AdakHaddad/BALAT/BALAT_PCB_v1/BALAT_PCB_v1/CETAK_SETRIKA_A4.pdf

## BALAT - pola tembaga untuk transfer setrika (2 kalung)

Cetak printer LASER, skala 100% / ukuran sebenarnya (matikan 'fit to page'). JANGAN dicerminkan: pola ini sudah benar untuk lapisan bawah. Hitam = tembaga yang dipertahankan. Titik putih kecil = tanda pusat bor (0,8-1 mm).

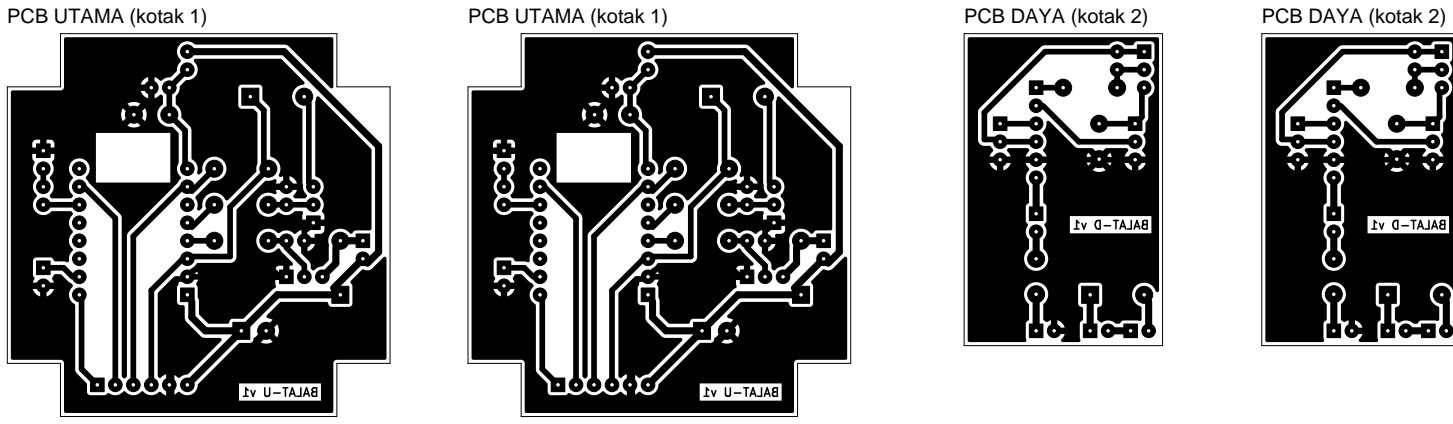
[picture p1: figure]
PCB UTAMA (kotak 1); PCB DAYA (kotak 2)
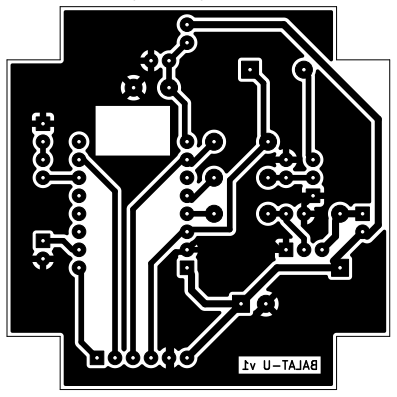
[picture p2: figure]

Garis ini harus tepat 50 mm. Ukur dengan penggaris sebelum menyetrika.

PCB utama = 54 x 54 mm, PCB daya = 28 x 44 mm. v1 | BALAT-U | v1 | BALAT-U
