AdakHaddad/BALAT/BALAT_PCB_v1/BALAT_PCB_v1/peta_daya.png

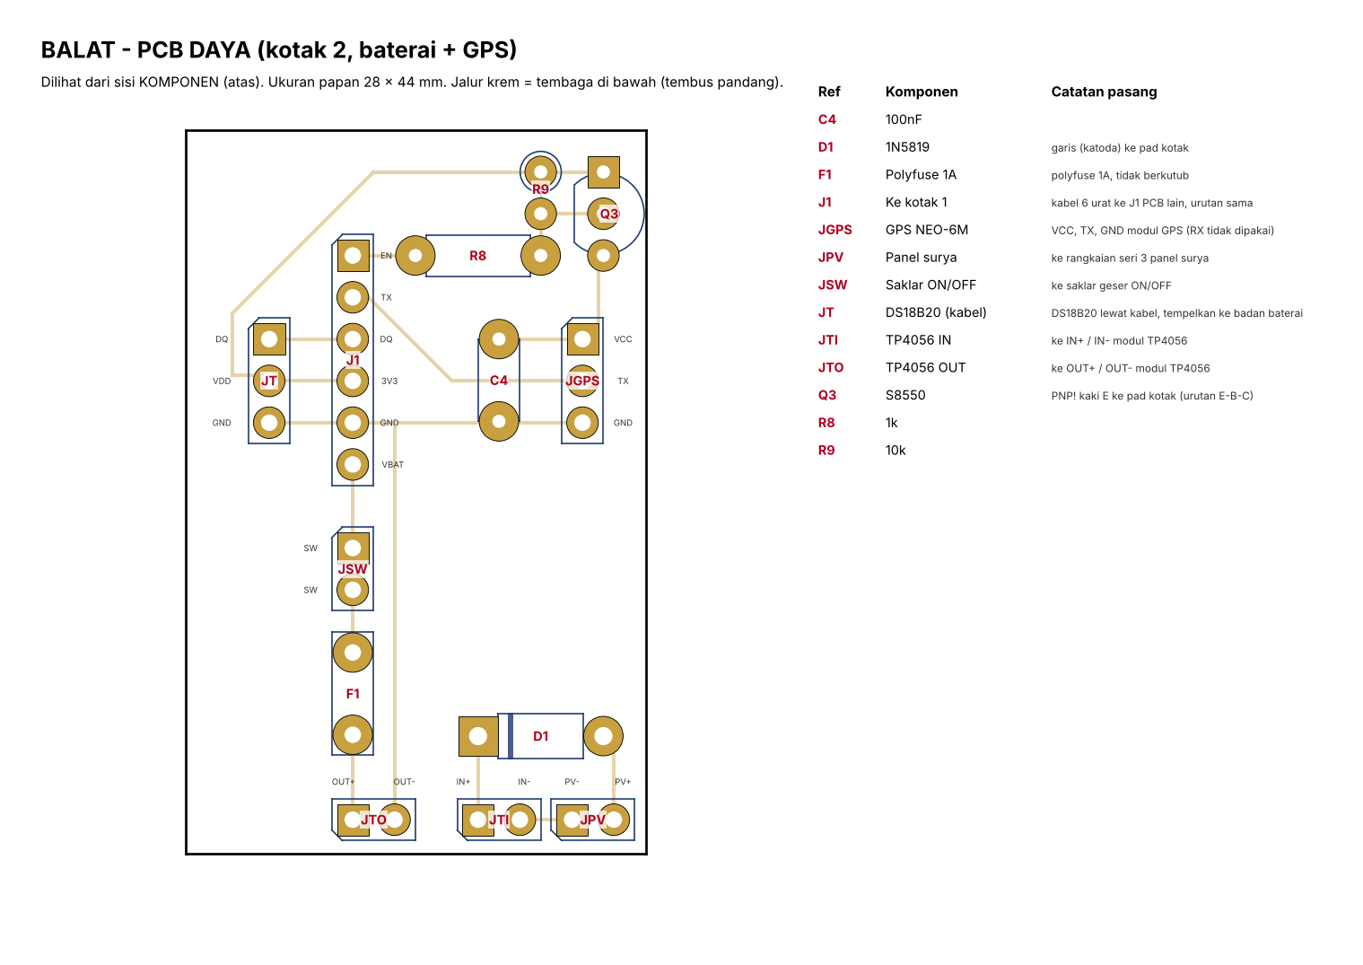
BALAT_PCB_v1/BALAT_PCB_v1/peta_daya.png
