AdakHaddad/BALAT/BALAT_PCB_v1/BALAT_PCB_v1/pratinjau_pcb.png

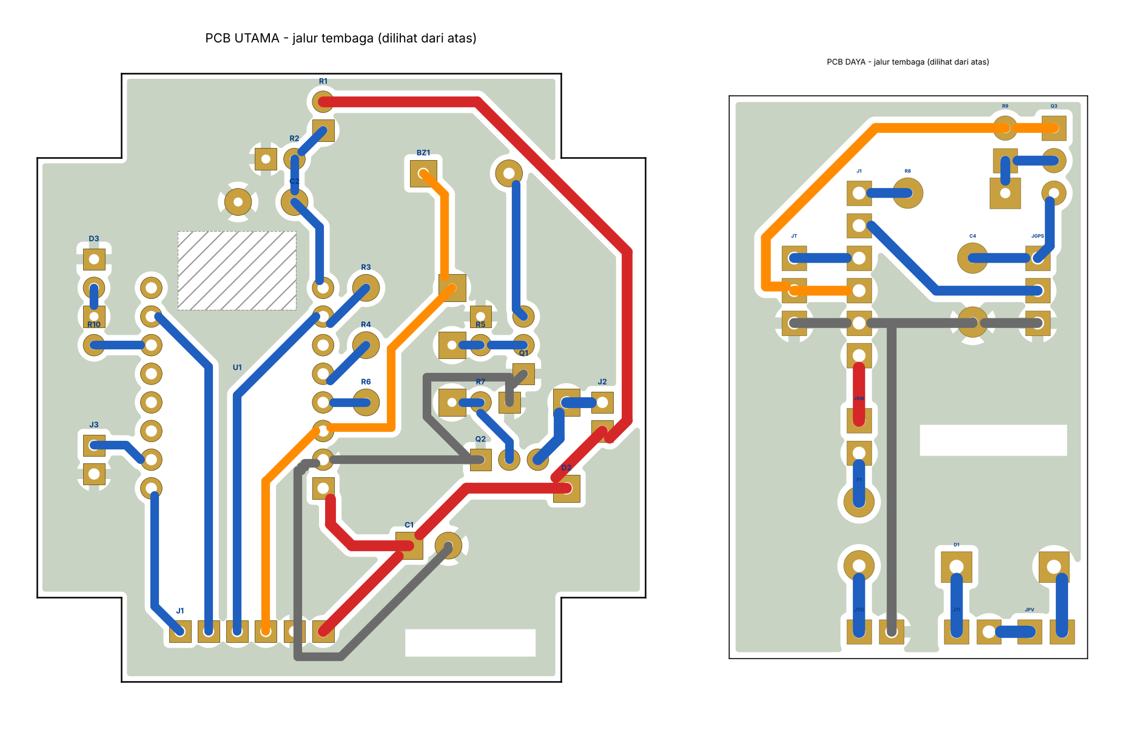
BALAT_PCB_v1/BALAT_PCB_v1/pratinjau_pcb.png
