AdakHaddad/BALAT/BALAT_PCB_v1/BALAT_PCB_v1/skematik/pratinjau_skematik.png

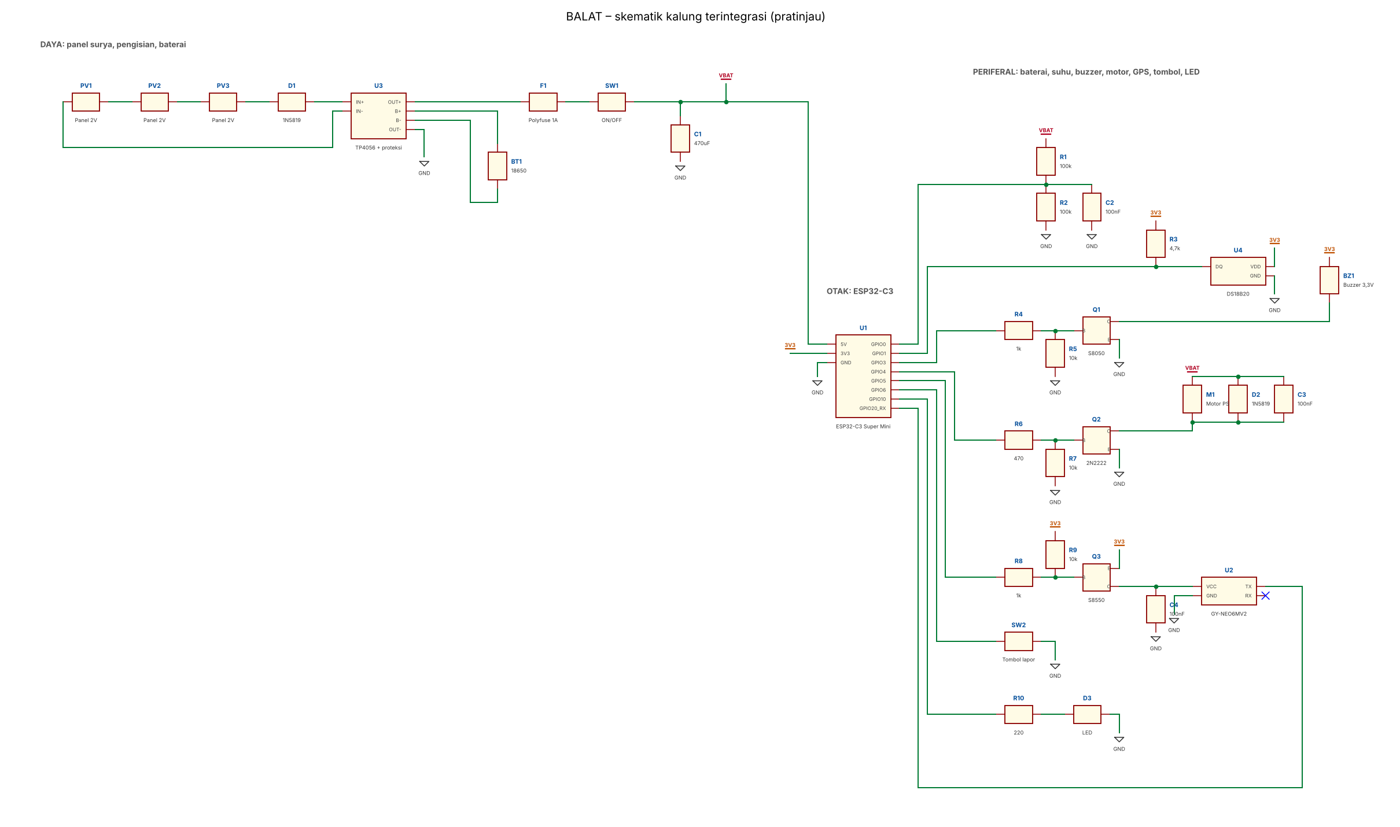
BALAT_PCB_v1/BALAT_PCB_v1/skematik/pratinjau_skematik.png
