AdakHaddad/BALAT/BALAT_PCB_v1/BALAT_PCB_v1/skematik/BOM_kalung.csv

Ref | Komponen | Jumlah per kalung | Jumlah 2 kalung
PV1 | Panel 2V | 1 | 2
PV2 | Panel 2V | 1 | 2
PV3 | Panel 2V | 1 | 2
D1 | 1N5819 | 1 | 2
U3 | TP4056 + proteksi | 1 | 2
BT1 | 18650 | 1 | 2
F1 | Polyfuse 1A | 1 | 2
SW1 | ON/OFF | 1 | 2
C1 | 470uF | 1 | 2
U1 | ESP32-C3 Super Mini | 1 | 2
R1 | 100k | 1 | 2
R2 | 100k | 1 | 2
C2 | 100nF | 1 | 2
R3 | 4,7k | 1 | 2
U4 | DS18B20 | 1 | 2
R4 | 1k | 1 | 2
R5 | 10k | 1 | 2
Q1 | S8050 | 1 | 2
BZ1 | Buzzer 3,3V | 1 | 2
R6 | 470 | 1 | 2
R7 | 10k | 1 | 2
Q2 | 2N2222 | 1 | 2
M1 | Motor PS | 1 | 2
D2 | 1N5819 | 1 | 2
C3 | 100nF | 1 | 2
R8 | 1k | 1 | 2
R9 | 10k | 1 | 2
Q3 | S8550 | 1 | 2
C4 | 100nF | 1 | 2
U2 | GY-NEO6MV2 | 1 | 2
SW2 | Tombol lapor | 1 | 2
R10 | 220 | 1 | 2
D3 | LED | 1 | 2
