AdakHaddad/BALAT/tb/nmea_test_vectors.txt

// Auto-generated by scripts/golden_nmea.py
// Format: one sentence per block.
// Line 1: expected lat_deg7 (signed hex 32-bit)
// Line 2: expected lon_deg7 (signed hex 32-bit)
// Line 3: expected speed_kn (hex 16-bit)
// Line 4: expected utc_time (hex 24-bit)
// Line 5: fix_valid (0 or 1)
// Line 6: expect_fix_ready (0 or 1)
// Line 7: sentence byte count (hex)
// Lines 8+: sentence bytes (hex, one per line)
//
// Basic GPRMC, north-east
1CAE1E08
06DD4DCB
0032
123519
1
1
40
24
47
50
52
4D
43
2C
31
32
33
35
31
39
2E
30
30
2C
41
2C
34
38
30
37
2E
30
33
38
30
2C
4E
2C
30
31
31
33
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
//
// GNRMC, south-west
EBD5F3A0
D5C525E0
04CE
091500
1
1
41
24
47
4E
52
4D
43
2C
30
39
31
35
30
30
2E
30
30
2C
41
2C
33
33
34
39
2E
38
30
30
30
2C
53
2C
30
37
30
35
31
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
//
// Void fix (status V)
00000000
00000000
0000
000000
0
1
40
24
47
50
52
4D
43
2C
30
30
30
30
30
30
2E
30
30
2C
56
2C
30
30
30
30
2E
30
30
30
30
2C
4E
2C
30
30
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
//
// High speed, high latitude
35A4E8EF
6B49D1EF
2706
235959
1
1
41
24
47
4E
52
4D
43
2C
32
33
35
39
35
39
2E
30
30
2C
41
2C
38
39
35
39
2E
39
39
39
39
2C
4E
2C
31
37
39
35
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
//
// Zero coordinates
00000000
00000000
0000
120000
1
1
40
24
47
50
52
4D
43
2C
31
32
30
30
30
30
2E
30
30
2C
41
2C
30
30
30
30
2E
30
30
30
30
2C
4E
2C
30
30
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
//
