AdakHaddad/BALAT/BALAT_PCB_v1/BALAT_PCB_v1/PETA_KOMPONEN.pdf

R1

R2

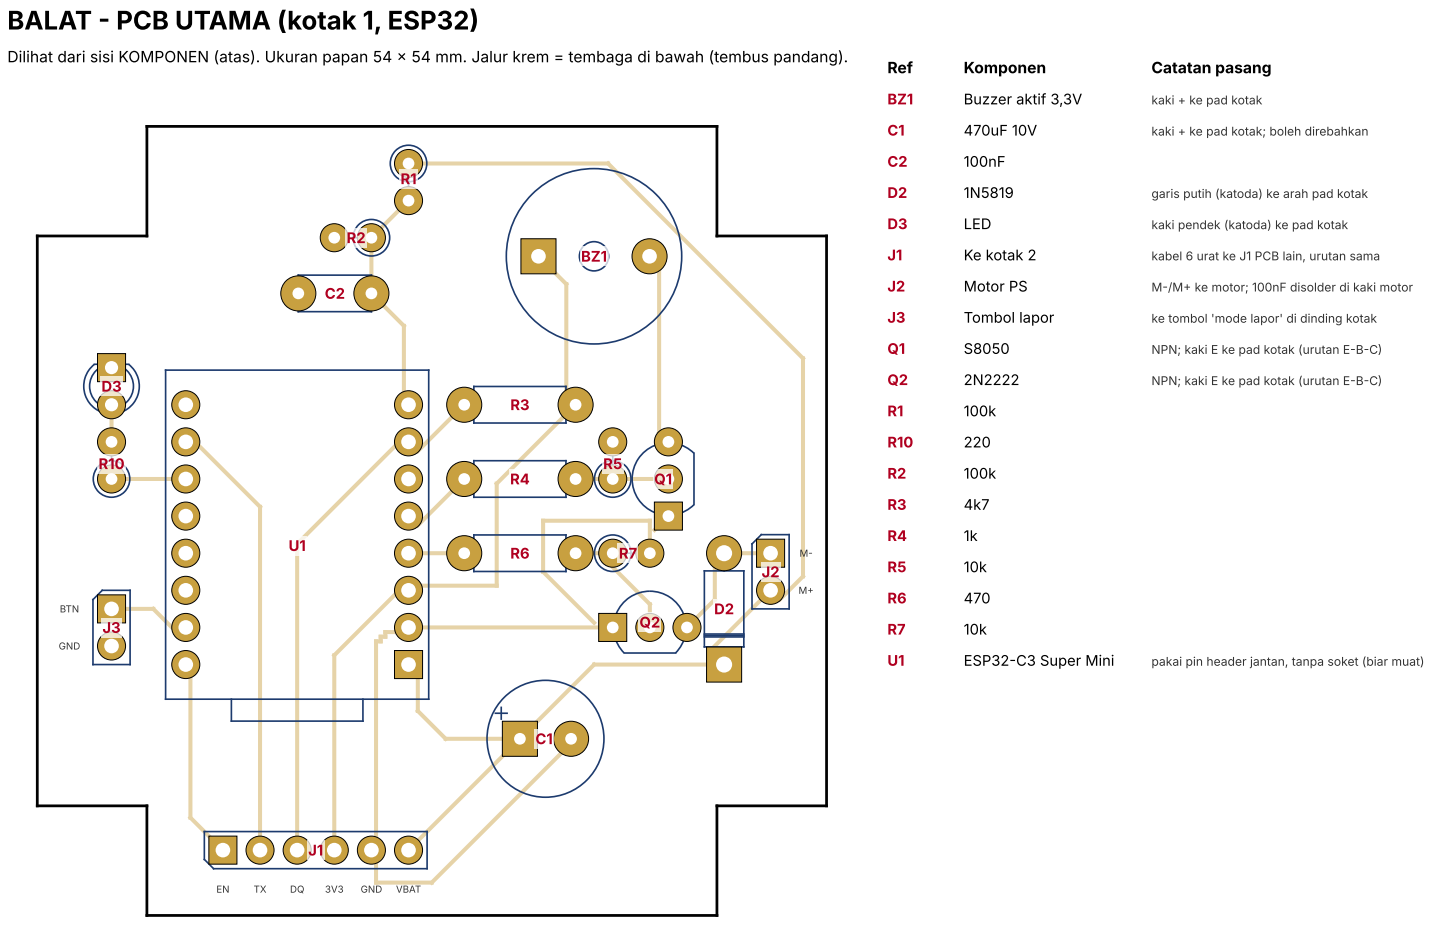
[picture p7: page 1]

BALAT - PCB UTAMA (kotak 1, ESP32)

Dilihat dari sisi KOMPONEN (atas). Ukuran papan 54 x 54 mm. Jalur krem = tembaga di bawah (tembus pandang).

Q3

R9

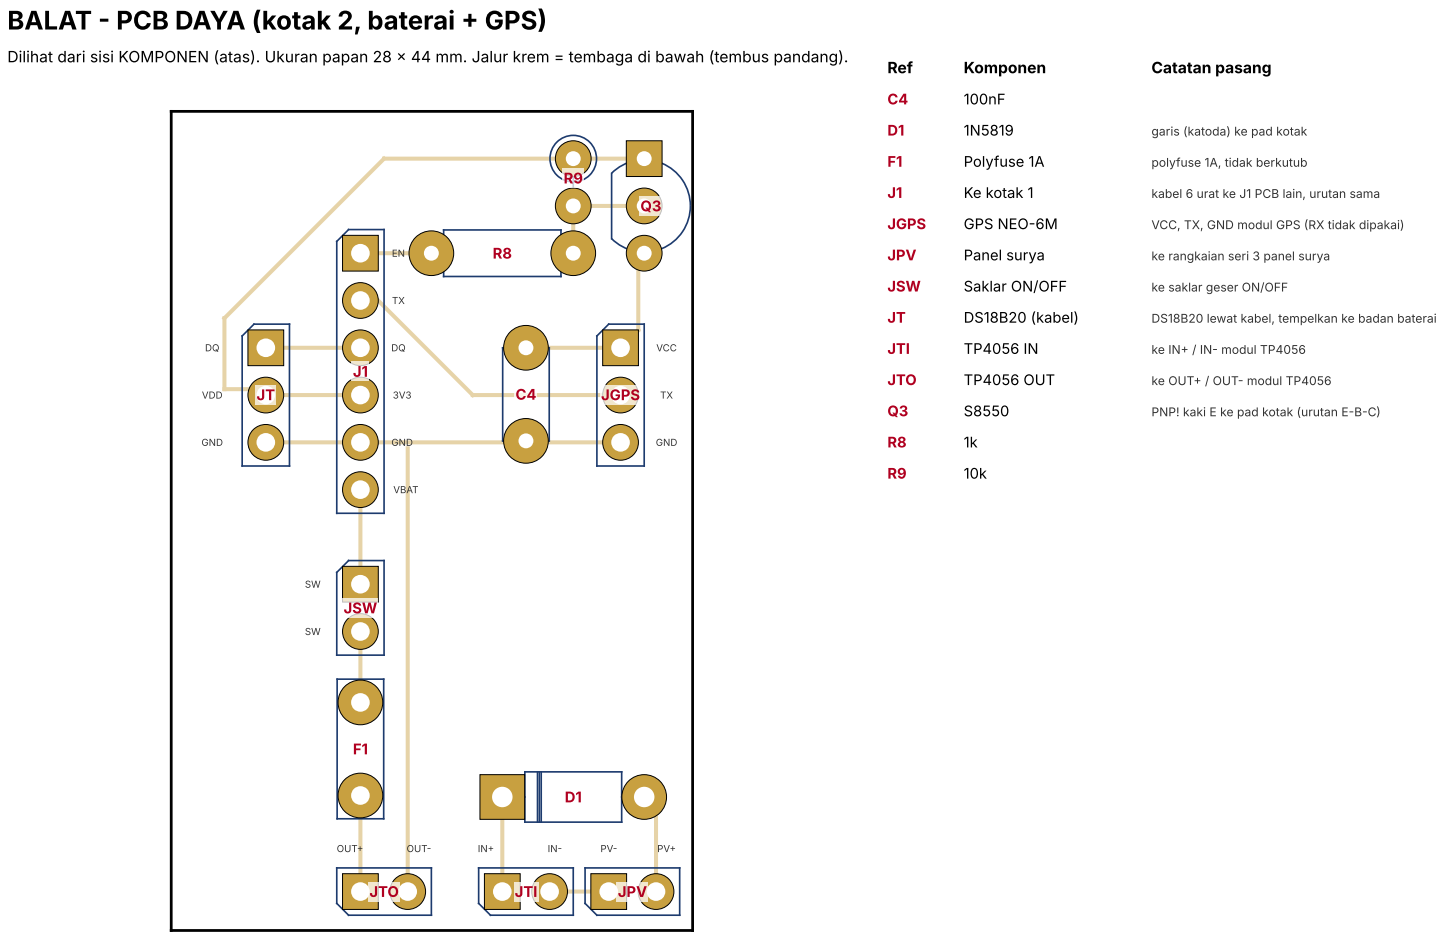
[picture p8: page 2]
JGPS; JPV; JSW; JTO; JTI; GND; VDD; VCC; VBAT; OUT+; OUT-; Ref; Komponen; Catatan pasang; garis (katoda) ke pad kotak; Polyfuse 1A; polyfuse 1A, tidak berkutub; Ke kotak 1; kabel 6 urat ke J1 PCB lain, urutan sama; GPS NEO-6M; VCC, TX, GND modul GPS (RX tidak dipakai); Panel surya; ke rangkaian seri 3 panel surya; Saklar ON/OFF; ke saklar geser ON/OFF; DS18B20 (kabel); DS18B20 lewat kabel, tempelkan ke badan baterai; ke IN+ / IN- modul TP4056; TP4056 OUT; ke OUT+ / OUT- modul TP4056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

BALAT - PCB DAYA (kotak 2, baterai + GPS)

Dilihat dari sisi KOMPONEN (atas). Ukuran papan 28 x 44 mm. Jalur krem = tembaga di bawah (tembus pandang).
