AdakHaddad/BALAT/BALAT_PCB_v1/BALAT_PCB_v1/utama/balat_utama.kicad_pcb

## KiCad design BALAT_PCB_v1/BALAT_PCB_v1/utama/balat_utama.kicad_pcb (2026-11-08)

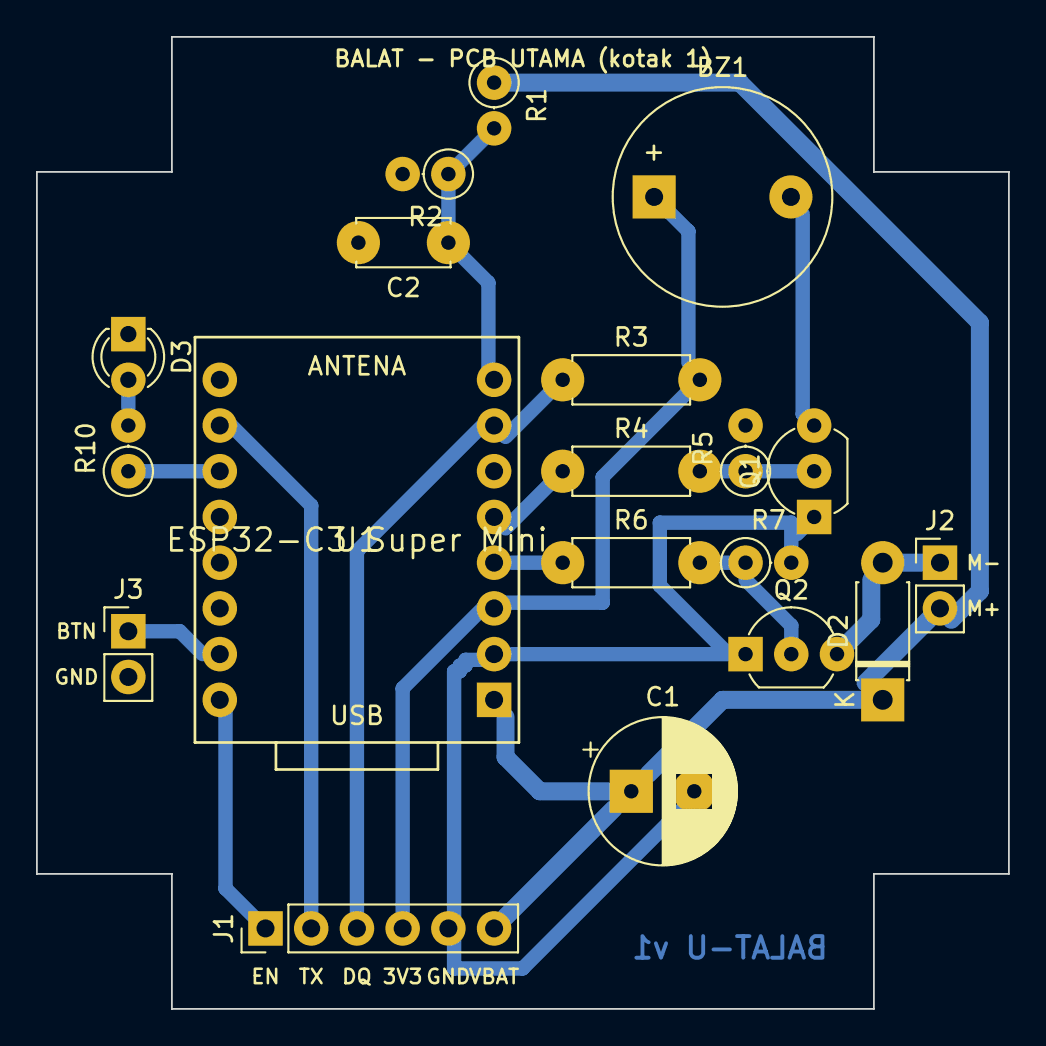
[picture p9: board balat_utama.kicad_pcb from above]

Board: 2 copper layers, 54.0 x 54.0 mm, 19 parts (0 on the bottom side), 16 nets.

Parts:
BZ1: Buzzer aktif 3,3V; Buzzer_12x9.5RM7.6
C1: 470uF 10V; CP_Radial_D8.0mm_P3.50mm
C2: 100nF; C_Disc_D5.0mm_W2.5mm_P5.00mm
D2: 1N5819; D_DO-41_SOD81_P7.62mm_Horizontal
D3: LED; LED_D3.0mm
J1: Ke kotak 2; PinHeader_1x06_P2.54mm_Vertical
J2: Motor PS; PinHeader_1x02_P2.54mm_Vertical
J3: Tombol lapor; PinHeader_1x02_P2.54mm_Vertical
Q1: S8050; TO-92_Inline_Wide
Q2: 2N2222; TO-92_Inline_Wide
R1, R2: 100k; R_Axial_DIN0207_L6.3mm_D2.5mm_P2.54mm_Vertical
R3: 4k7; R_Axial_DIN0207_L6.3mm_D2.5mm_P7.62mm_Horizontal
R4: 1k; R_Axial_DIN0207_L6.3mm_D2.5mm_P7.62mm_Horizontal
R5, R7: 10k; R_Axial_DIN0207_L6.3mm_D2.5mm_P2.54mm_Vertical
R6: 470; R_Axial_DIN0207_L6.3mm_D2.5mm_P7.62mm_Horizontal
R10: 220; R_Axial_DIN0207_L6.3mm_D2.5mm_P2.54mm_Vertical
U1: ESP32-C3 Super Mini; ESP32-C3_SuperMini

Connections:
3V3: BZ1.1, J1.4, R3.2, U1.3V3
BTN: J3.1, U1.IO6
BUZ_CTRL: R4.1, U1.IO3
BUZ_N: BZ1.2, Q1.3
GND: C1.2, C2.2, D3.1, J1.5, J3.2, Q1.1, Q2.1, R2.2, R5.2, R7.2, U1.GND
GPS_EN: J1.1, U1.IO5
GPS_TX: J1.2, U1.IO20
LED_A: D3.2, R10.2
LED_CTRL: R10.1, U1.IO10
MOT_CTRL: R6.1, U1.IO4
MOT_N: D2.2, J2.1, Q2.3
Q1_B: Q1.2, R4.2, R5.1
Q2_B: Q2.2, R6.2, R7.1
TEMP_DQ: J1.3, R3.1, U1.IO1
VBAT: C1.1, D2.1, J1.6, J2.2, R1.1, U1.5V
VBAT_SENSE: C2.1, R1.2, R2.1, U1.IO0
