AdakHaddad/BALAT/BALAT_PCB_v1/BALAT_PCB_v1/daya/balat_daya.kicad_pcb

## KiCad design BALAT_PCB_v1/BALAT_PCB_v1/daya/balat_daya.kicad_pcb (2026-11-08)

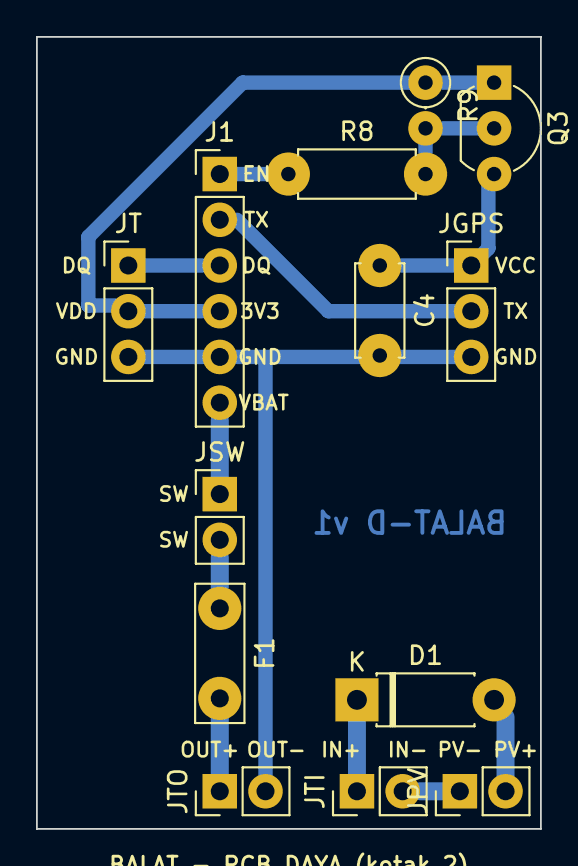
[picture p10: board balat_daya.kicad_pcb from above]

Board: 2 copper layers, 28.0 x 44.0 mm, 13 parts (0 on the bottom side), 13 nets.

Parts:
C4: 100nF; C_Disc_D5.0mm_W2.5mm_P5.00mm
D1: 1N5819; D_DO-41_SOD81_P7.62mm_Horizontal
F1: Polyfuse 1A; C_Disc_D7.5mm_W2.5mm_P5.00mm
J1: Ke kotak 1; PinHeader_1x06_P2.54mm_Vertical
JGPS: GPS NEO-6M; PinHeader_1x03_P2.54mm_Vertical
JPV: Panel surya; PinHeader_1x02_P2.54mm_Vertical
JSW: Saklar ON/OFF; PinHeader_1x02_P2.54mm_Vertical
JT: DS18B20 (kabel); PinHeader_1x03_P2.54mm_Vertical
JTI: TP4056 IN; PinHeader_1x02_P2.54mm_Vertical
JTO: TP4056 OUT; PinHeader_1x02_P2.54mm_Vertical
Q3: S8550; TO-92_Inline_Wide
R8: 1k; R_Axial_DIN0207_L6.3mm_D2.5mm_P7.62mm_Horizontal
R9: 10k; R_Axial_DIN0207_L6.3mm_D2.5mm_P2.54mm_Vertical

Connections:
3V3: J1.4, JT.2, Q3.1, R9.1
FUSED: F1.1, JSW.2
GND: C4.2, J1.5, JGPS.3, JT.3, JTO.2
GPS_EN: J1.1, R8.1
GPS_TX: J1.2, JGPS.2
GPS_VCC: C4.1, JGPS.1, Q3.3
PV_MIN: JPV.1, JTI.2
Q3_B: Q3.2, R8.2, R9.2
SOLAR_IN: D1.1, JTI.1
SOLAR_RAW: D1.2, JPV.2
TEMP_DQ: J1.3, JT.1
TP_OUT: F1.2, JTO.1
VBAT: J1.6, JSW.1
