AdakHaddad/BALAT/constraints/basys3_herdsync.xdc

# Basys 3 rev B constraints for the HerdSync-DTN USB-UART bridge demo.
# Pin locations are taken from Digilent's Basys-3-Master.xdc.
# Only the ports used by balat_herdsync_basys3_top are constrained.

## Clock
set_property -dict { PACKAGE_PIN W5   IOSTANDARD LVCMOS33 } [get_ports clk]
create_clock -add -name sys_clk_pin -period 10.00 -waveform {0 5} [get_ports clk]

## Switches SW0..SW3
set_property -dict { PACKAGE_PIN V17  IOSTANDARD LVCMOS33 } [get_ports {sw[0]}]
set_property -dict { PACKAGE_PIN V16  IOSTANDARD LVCMOS33 } [get_ports {sw[1]}]
set_property -dict { PACKAGE_PIN W16  IOSTANDARD LVCMOS33 } [get_ports {sw[2]}]
set_property -dict { PACKAGE_PIN W17  IOSTANDARD LVCMOS33 } [get_ports {sw[3]}]

## LEDs
set_property -dict { PACKAGE_PIN U16  IOSTANDARD LVCMOS33 } [get_ports {led[0]}]
set_property -dict { PACKAGE_PIN E19  IOSTANDARD LVCMOS33 } [get_ports {led[1]}]
set_property -dict { PACKAGE_PIN U19  IOSTANDARD LVCMOS33 } [get_ports {led[2]}]
set_property -dict { PACKAGE_PIN V19  IOSTANDARD LVCMOS33 } [get_ports {led[3]}]
set_property -dict { PACKAGE_PIN W18  IOSTANDARD LVCMOS33 } [get_ports {led[4]}]
set_property -dict { PACKAGE_PIN U15  IOSTANDARD LVCMOS33 } [get_ports {led[5]}]
set_property -dict { PACKAGE_PIN U14  IOSTANDARD LVCMOS33 } [get_ports {led[6]}]
set_property -dict { PACKAGE_PIN V14  IOSTANDARD LVCMOS33 } [get_ports {led[7]}]
set_property -dict { PACKAGE_PIN V13  IOSTANDARD LVCMOS33 } [get_ports {led[8]}]
set_property -dict { PACKAGE_PIN V3   IOSTANDARD LVCMOS33 } [get_ports {led[9]}]
set_property -dict { PACKAGE_PIN W3   IOSTANDARD LVCMOS33 } [get_ports {led[10]}]
set_property -dict { PACKAGE_PIN U3   IOSTANDARD LVCMOS33 } [get_ports {led[11]}]
set_property -dict { PACKAGE_PIN P3   IOSTANDARD LVCMOS33 } [get_ports {led[12]}]
set_property -dict { PACKAGE_PIN N3   IOSTANDARD LVCMOS33 } [get_ports {led[13]}]
set_property -dict { PACKAGE_PIN P1   IOSTANDARD LVCMOS33 } [get_ports {led[14]}]
set_property -dict { PACKAGE_PIN L1   IOSTANDARD LVCMOS33 } [get_ports {led[15]}]

## Center button (active-high reset)
set_property -dict { PACKAGE_PIN U18  IOSTANDARD LVCMOS33 } [get_ports btnC]

## Pmod JA1: logic-level cue observation only. Never connect an actuator directly.
set_property -dict { PACKAGE_PIN J1   IOSTANDARD LVCMOS33 } [get_ports cue_out]

## USB-UART bridge (FTDI channel B)
set_property -dict { PACKAGE_PIN B18  IOSTANDARD LVCMOS33 } [get_ports RsRx]
set_property -dict { PACKAGE_PIN A18  IOSTANDARD LVCMOS33 } [get_ports RsTx]
set_false_path -from [get_ports RsRx]

## Board configuration
set_property CONFIG_VOLTAGE 3.3 [current_design]
set_property CFGBVS VCCO [current_design]
set_property BITSTREAM.GENERAL.COMPRESS TRUE [current_design]
set_property BITSTREAM.CONFIG.CONFIGRATE 33 [current_design]
