AdakHaddad/BALAT/rtl/balat_herdsync_basys3_top.v

// balat_herdsync_basys3_top — Basys 3 risk demo plus USB-UART record bridge.
//
// This is a bench integration for the post-v0.1 HerdSync-DTN POC. The risk
// pipeline and cue output are unchanged from balat_basys3_top. The bridge emits
// an unsigned framed record on the on-board USB-UART and accepts peer summaries
// from a host. It is not a BLE stack and does not feed the cue path.
//
// Controls:
//   SW0 run/pause, SW1 force stale, SW2 enable cue, SW3 force map fault.
//   BTNC reset (active high).
//
// LEDs:
//   LED0 SAFE, LED1 CAUTION, LED2 DANGER, LED3 COOLDOWN,
//   LED4 INVALID/FAULT, LED5 cue active, LED6 UART telemetry heartbeat,
//   LED7 board heartbeat. LED8..LED15 are inactive for a simple POC display.
module balat_herdsync_basys3_top #(
    parameter integer CLK_PER_TICK   = 10_000_000,
    parameter integer LAST_INDEX     = 200,
    parameter integer CLK_PER_MS     = 100_000,
    parameter integer STALE_MS       = 500,
    parameter integer MAX_ON_TICKS   = 5,
    parameter integer COOLDOWN_TICKS = 30,
    parameter integer HEARTBEAT_DIV  = 50_000_000,
    parameter integer UART_CLK_HZ    = 100_000_000,
    parameter integer UART_BAUD      = 115200
) (
    input  wire        clk,
    input  wire        btnC,
    input  wire [3:0]  sw,
    input  wire        RsRx,
    output wire [15:0] led,
    output wire        cue_out,
    output wire        RsTx
);

    localparam [2:0] ST_INVALID  = 3'd0;
    localparam [2:0] ST_SAFE     = 3'd1;
    localparam [2:0] ST_CAUTION  = 3'd2;
    localparam [2:0] ST_DANGER   = 3'd3;
    localparam [2:0] ST_COOLDOWN = 3'd4;

    (* ASYNC_REG = "TRUE" *) reg [2:0] rst_sync;
    wire rst;

    always @(posedge clk or posedge btnC) begin
        if (btnC)
            rst_sync <= 3'b111;
        else
            rst_sync <= {rst_sync[1:0], 1'b0};
    end
    assign rst = rst_sync[2];

    wire run         = sw[0];
    wire force_stale = sw[1];
    wire cue_enable  = sw[2];
    wire map_valid   = ~sw[3];

    wire        sample_tick;
    wire [15:0] trace_index;
    wire signed [31:0] rom_data;

    trace_player #(
        .CLK_PER_TICK (CLK_PER_TICK),
        .LAST_INDEX   (LAST_INDEX)
    ) u_trace_player (
        .clk   (clk),
        .rst   (rst),
        .run   (run),
        .tick  (sample_tick),
        .index (trace_index)
    );

    demo_trace_rom u_trace_rom (
        .addr (trace_index),
        .data (rom_data)
    );

    wire signed [15:0] trace_x16 = rom_data[31:16];
    wire signed [15:0] trace_y16 = rom_data[15:0];
    wire signed [31:0] px = {{16{trace_x16[15]}}, trace_x16};
    wire signed [31:0] py = {{16{trace_y16[15]}}, trace_y16};

    wire [63:0] dist2;

    road_geom u_road_geom (
        .clk     (clk),
        .rst     (rst),
        .px      (px),
        .py      (py),
        .ax      (-32'sd2000),
        .ay      (32'sd0),
        .bx      (32'sd2000),
        .by      (32'sd0),
        .ux_q14  (16'sd16384),
        .uy_q14  (16'sd0),
        .dist2   (dist2),
        .inside_span ()
    );

    reg [63:0] prev_dist2;
    wire approaching = (dist2 < prev_dist2);

    always @(posedge clk) begin
        if (rst)
            prev_dist2 <= 64'hFFFFFFFFFFFFFFFF;
        else if (sample_tick)
            prev_dist2 <= dist2;
    end

    reg [31:0] ms_cnt;
    reg [31:0] stale_cnt;
    reg        stale;
    reg        sample_seen;
    wire       ms_tick = (ms_cnt >= (CLK_PER_MS - 1));

    always @(posedge clk) begin
        if (rst) begin
            ms_cnt      <= 32'd0;
            stale_cnt   <= 32'd0;
            stale       <= 1'b1;
            sample_seen <= 1'b0;
        end else begin
            if (ms_tick)
                ms_cnt <= 32'd0;
            else
                ms_cnt <= ms_cnt + 32'd1;

            if (sample_tick)
                sample_seen <= 1'b1;

            if (ms_tick) begin
                if (sample_seen) begin
                    sample_seen <= 1'b0;
                    stale_cnt   <= 32'd0;
                    stale       <= 1'b0;
                end else if (stale_cnt >= (STALE_MS - 1)) begin
                    stale <= 1'b1;
                end else begin
                    stale_cnt <= stale_cnt + 32'd1;
                end
            end
        end
    end

    wire stale_now = stale | force_stale | ~map_valid;

    wire [2:0] risk_state;
    wire [2:0] display_state = stale_now ? ST_INVALID : risk_state;
    wire       cue_req;
    wire       fault;
    wire       cue_en;
    wire       cooldown;

    risk_fsm u_risk_fsm (
        .clk          (clk),
        .rst          (rst),
        .sample_valid (sample_tick),
        .stale        (stale_now),
        .map_valid    (map_valid),
        .cooldown     (cooldown),
        .approaching  (approaching),
        .dist2        (dist2),
        .state        (risk_state),
        .cue_req      (cue_req),
        .fault        (fault)
    );

    cue_scheduler #(
        .MAX_ON_TICKS   (MAX_ON_TICKS),
        .COOLDOWN_TICKS (COOLDOWN_TICKS)
    ) u_cue_scheduler (
        .clk      (clk),
        .rst      (rst),
        .tick     (sample_tick),
        .enable   (cue_enable),
        .request  (cue_req),
        .cue_en   (cue_en),
        .cooldown (cooldown)
    );

    wire cue_active = cue_en & cue_enable & ~stale_now & map_valid;

    // The risk FSM updates on the sample tick, so a record latched on that same
    // edge would carry the previous state while the LEDs already show the new
    // one. Capture the sample position and latch the UART record one clock
    // later, using the exact state the LEDs display.
    reg               record_tick;
    reg signed [31:0] px_d;
    reg signed [31:0] py_d;
    reg signed [31:0] record_x;
    reg signed [31:0] record_y;

    always @(posedge clk) begin
        if (rst) begin
            record_tick <= 1'b0;
            px_d        <= 32'sd0;
            py_d        <= 32'sd0;
            record_x    <= 32'sd0;
            record_y    <= 32'sd0;
        end else begin
            px_d        <= px;
            py_d        <= py;
            record_tick <= sample_tick;
            if (sample_tick) begin
                record_x <= px_d;
                record_y <= py_d;
            end
        end
    end

    wire        uart_tx_busy;
    wire [15:0] bridge_frames_sent;
    wire [15:0] bridge_frames_received;
    wire [15:0] bridge_crc_errors;
    wire [15:0] bridge_tx_drops;
    wire [15:0] bridge_rx_errors;
    wire [31:0] bridge_peer_id;
    wire [31:0] bridge_peer_seq;
    wire [31:0] bridge_peer_fix_s;
    wire [2:0]  bridge_peer_risk;
    wire        bridge_peer_seen;

    herdsync_uart_bridge #(
        .CLK_HZ    (UART_CLK_HZ),
        .BAUD      (UART_BAUD),
        .ORIGIN_ID (32'd1),
        .EPOCH     (16'd1)
    ) u_bridge (
        .clk              (clk),
        .rst              (rst),
        .sample_tick      (record_tick),
        .sample_valid     (record_tick),
        .stale            (stale_now),
        .risk             (display_state),
        .x_cm             (record_x),
        .y_cm             (record_y),
        .uart_rx          (RsRx),
        .uart_tx          (RsTx),
        .tx_busy          (uart_tx_busy),
        .frames_sent      (bridge_frames_sent),
        .frames_received  (bridge_frames_received),
        .crc_errors       (bridge_crc_errors),
        .tx_drops         (bridge_tx_drops),
        .rx_errors        (bridge_rx_errors),
        .last_peer_id     (bridge_peer_id),
        .last_peer_seq    (bridge_peer_seq),
        .last_peer_fix_s  (bridge_peer_fix_s),
        .last_peer_risk   (bridge_peer_risk),
        .peer_seen        (bridge_peer_seen)
    );

    reg [31:0] hb_cnt;
    reg        heartbeat;

    always @(posedge clk) begin
        if (rst) begin
            hb_cnt    <= 32'd0;
            heartbeat <= 1'b0;
        end else if (hb_cnt >= (HEARTBEAT_DIV - 1)) begin
            hb_cnt    <= 32'd0;
            heartbeat <= ~heartbeat;
        end else begin
            hb_cnt <= hb_cnt + 32'd1;
        end
    end

    assign cue_out = cue_active;

    // The LEDs and the UART record use the same display_state, so the board and
    // dashboard always show the same high-level status.
    assign led[0]    = (display_state == ST_SAFE);
    assign led[1]    = (display_state == ST_CAUTION);
    assign led[2]    = (display_state == ST_DANGER);
    assign led[3]    = (display_state == ST_COOLDOWN);
    assign led[4]    = (display_state == ST_INVALID) | fault;
    assign led[5]    = cue_active;
    assign led[6]    = bridge_frames_sent[0];
    assign led[7]    = heartbeat;
    assign led[15:8] = 8'd0;

endmodule
