AdakHaddad/BALAT/(commit log)

2026-11-01 Connect Basys3 dashboard POC and sync risk with LEDs
2026-11-02 Ignore local pitch deck artifacts
2026-11-04 docs: add FPGA and MCU prototype runbooks
2026-11-06 feat: add ESP32-C3 bench prototype
2026-11-06 fix: build ESP32-C3 cue module selection
    [main.c]
